cclmt/Drone-Terrestre-Wifi/Circuit_R&T_Enterprise_v0.9p.jpg

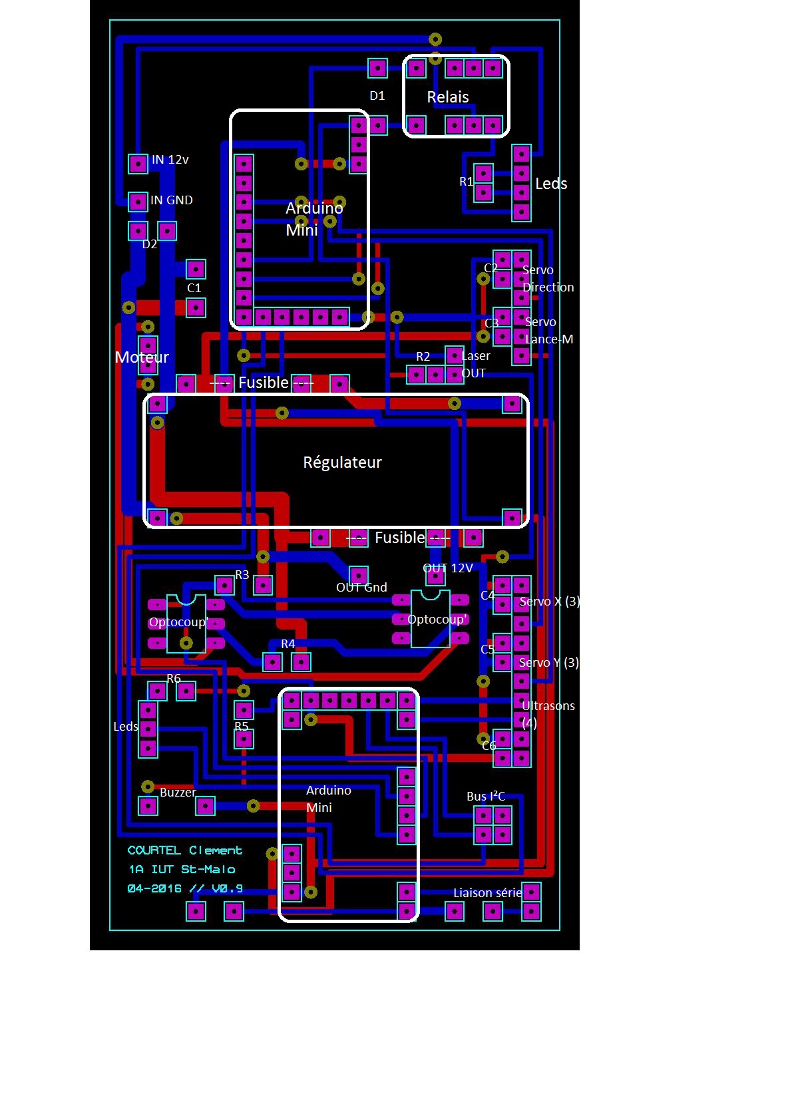
Circuit_R&T_Enterprise_v0.9p.jpg
