cclmt/Drone-Terrestre-Wifi/README.md

# Drone-Terrestre-Wifi
Programmes du projet tuteuré, 2015-2016, avc IUT de St-Malo, dpt Réseaux et Télécommunications
