cclmt/Drone-Terrestre-Wifi/(list of files, drawings)

Other design files:
Projet-tuteuré_circuit_COURTEL_0.9.pdsprj
